idan/pixel64/(commit log)

2026-06-19 Add scenes architecture design docs (#1)
    Design-stage documents for the scene system that drives the panel: a
    layer-stack compositor model with four layer kinds (image, animation,
    text, procedural shader), data-binding for templated/live scenes, an
    f32 stack-based shader VM with per-frame/per-pixel execution, a
    GLSL-flavored authoring language, the bundle format, device runtime,
    WebSocket+Durable-Object transport, and the web preview/parity strategy.
    No implementation yet — these settle the architecture before code.
2026-06-19 docs: document single 5V supply powering panel + MCU (#2)
    Expand the Power section of hardware-wiring.md to cover running the whole
    device from one 5 V rail: split-rail wiring, Pico 2 W VSYS input (and the
    D1 Schottky / USB caveat), supply sizing with headroom rationale, and rail
    hygiene (bulk cap) to mitigate brownout/flicker.
2026-06-20 M1: cyw43 radio bring-up + onboard-LED blink
    Initialize the CYW43439 over PIO0-emulated SPI (PINs 23/24/25/29,
    DMA_CH0), upload the Wi-Fi firmware blob, and blink the onboard LED via
    control.gpio_set(0, …) — keeping USB-serial logging so each step is
    visible on the one cable. Verified on hardware: LED blinks, serial shows
    "cyw43 up".
    Proves the radio chip + firmware blobs + PIO-SPI link all work, the
    foundation for the Wi-Fi/BLE ports. Pinned to the real crates.io
    cyw43 0.7 / cyw43-pio 0.10 API (Runner has 2 generics not 3; clm goes to
    control.init(); DMA needs Channel::new(ch, Irqs)).
    Vendor cyw43-firmware/ blobs (Wi-Fi fw/clm/nvram + the BT fw for the
    upcoming BLE spike) under their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
2026-06-20 docs: mark M2a (Wi-Fi join) done; stage 2b/2c in port plan
2026-06-20 M2b: BLE peripheral on cyw43 via trouble-host
    Bring up Bluetooth LE on the CYW43439: cyw43::new_with_bluetooth (BT
    firmware blob + `bluetooth` feature) yields a BtDriver, wrapped in
    bt-hci's ExternalController and driven by trouble-host 0.6. Advertise as
    `pixel64` with a battery service; accept connections and serve GATT.
    Verified on hardware (nRF Connect connects + reads battery level).
    Dependency route B (see docs): pin trouble-host to 0.6 so its bt-hci 0.8
    matches cyw43 0.7.0's — trouble 0.7 needs bt-hci 0.9, which cyw43 can't
    provide. This brings back the embassy-sync 0.7/0.8 split (direct
    embassy-sync = "0.7" for trouble's gatt macros). docs/pico-port.md adds a
    "Dependency compatibil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
2026-06-22 Solve macOS Improv provisioning + add web BLE test client
    macOS Chrome provisioning failed not because of the device but because
    the Improv JS SDK wrote credentials with writeValueWithoutResponse(),
    which Chrome on macOS silently drops via CoreBluetooth's flaky
    canSendWriteWithoutResponse flow control (improv-wifi/sdk-ble-js#213,
    fixed upstream in PR #217 by using writeValue / write-with-response).
    This is why it reproduced identically on esp-radio and cyw43 — the write
    never left the Mac. Our firmware was always correct; rpc_command already
    exposes Write (with response).
    - web/improv-test/: a zero-build Web Bluetooth Improv client that
    provisions using write-with-response, with a check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
    [improv.rs]
2026-06-22 Thin the baffle walls, lower height, and document printing
    Tune the baffle for reliable printing and better optics after testing
    against the real panel + diffuser:
    - wall 0.45 -> 0.42mm: under Arachne the model thickness IS the printed
    single-line width, so this directly thins the light-blocking walls
    (0.40 = nozzle is the floor). Drop the obsolete thin-wall-detection note.
    - height 5 -> 3mm: 5mm over-isolated and blocked too much off-axis light;
    ~3mm gives clean per-pixel cells and prints far easier (7:1 vs 12:1
    aspect at 0.42 wall).
    - Add printing.md: flow/pressure-advance calibration, adhesion settings,
    the clean-first-layer fix, Z-offset/squish reading guide, and the
    large-p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
    [baffle-mini.scad, baffle.scad]
2026-06-22 Untrack generated STLs; add render.sh to rebuild them
    STLs are build artifacts of the .scad sources, so stop versioning them.
    render.sh regenerates every *.scad via OpenSCAD (PATH or the macOS app
    bundle); gitignore keeps *.stl out of the repo. baffle-mini.stl was
    tracked since the initial baffle commit; drop it from tracking here.
    [baffle-mini.stl]
